falco81/BLE-RS232-Bridge/doc/Fig-4-MAX232-RS232-level-converter.png

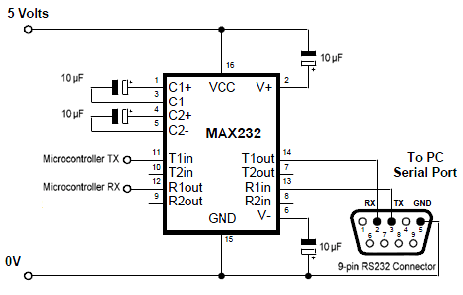
doc/Fig-4-MAX232-RS232-level-converter.png
