falco81/BLE-RS232-Bridge/doc/WemosD1MiniESP32.png

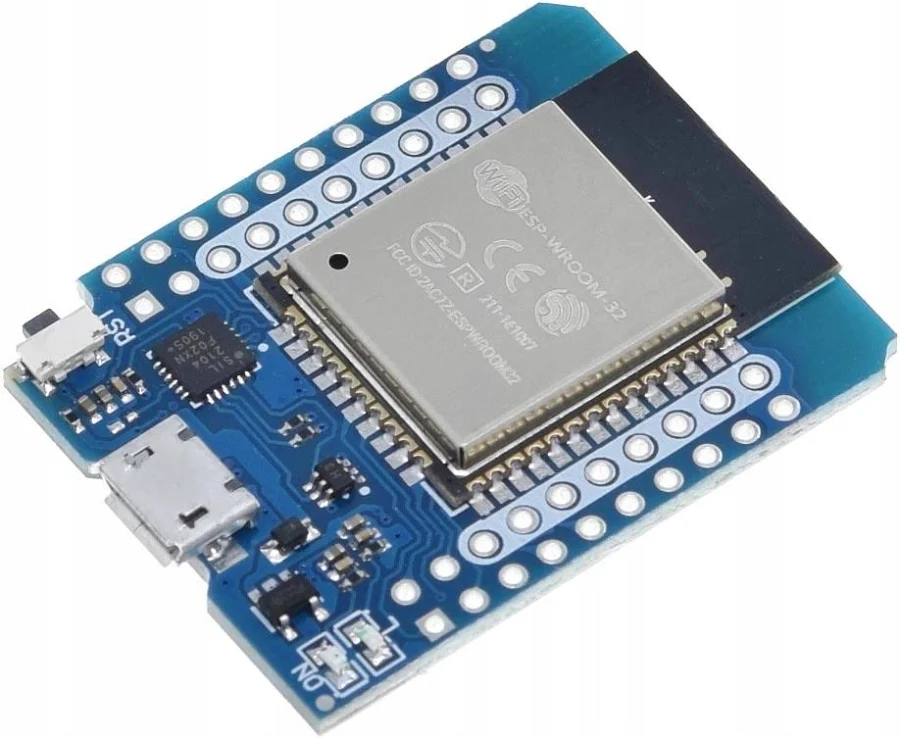
doc/WemosD1MiniESP32.png
